iorodeo/ph_featherwing/README.md

# IO Rodeo pH Feather Wing

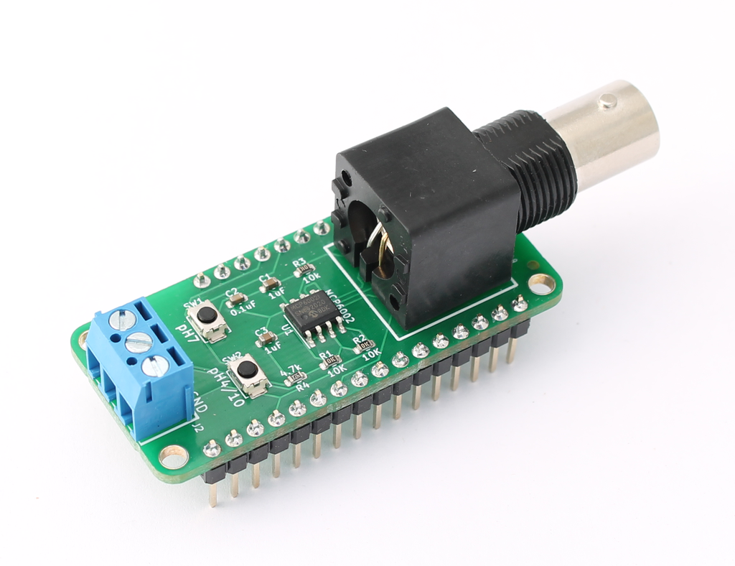
[picture p1: images/ph_feather_wing_v0p2.png]


Hardware design for IO Rodeo's pH Feather Wing (in development).
