iorodeo/ph_featherwing/v0p1/README.md

# IO Rodeo pH Feather Wing

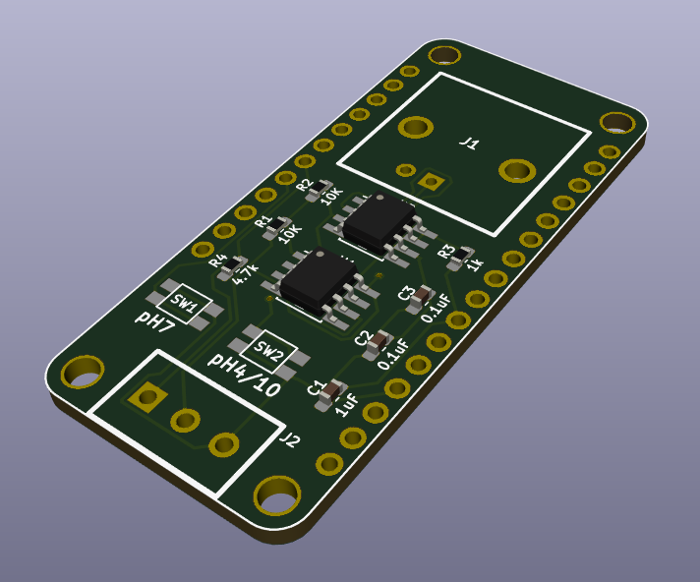
[picture p2: images/ph_feather_wing_3D_kicad.png]


Hardware design for IO Rodeo's pH Feather Wing (in development).
