iorodeo/ph_featherwing/v0p1/ph_feather_wing.pdf

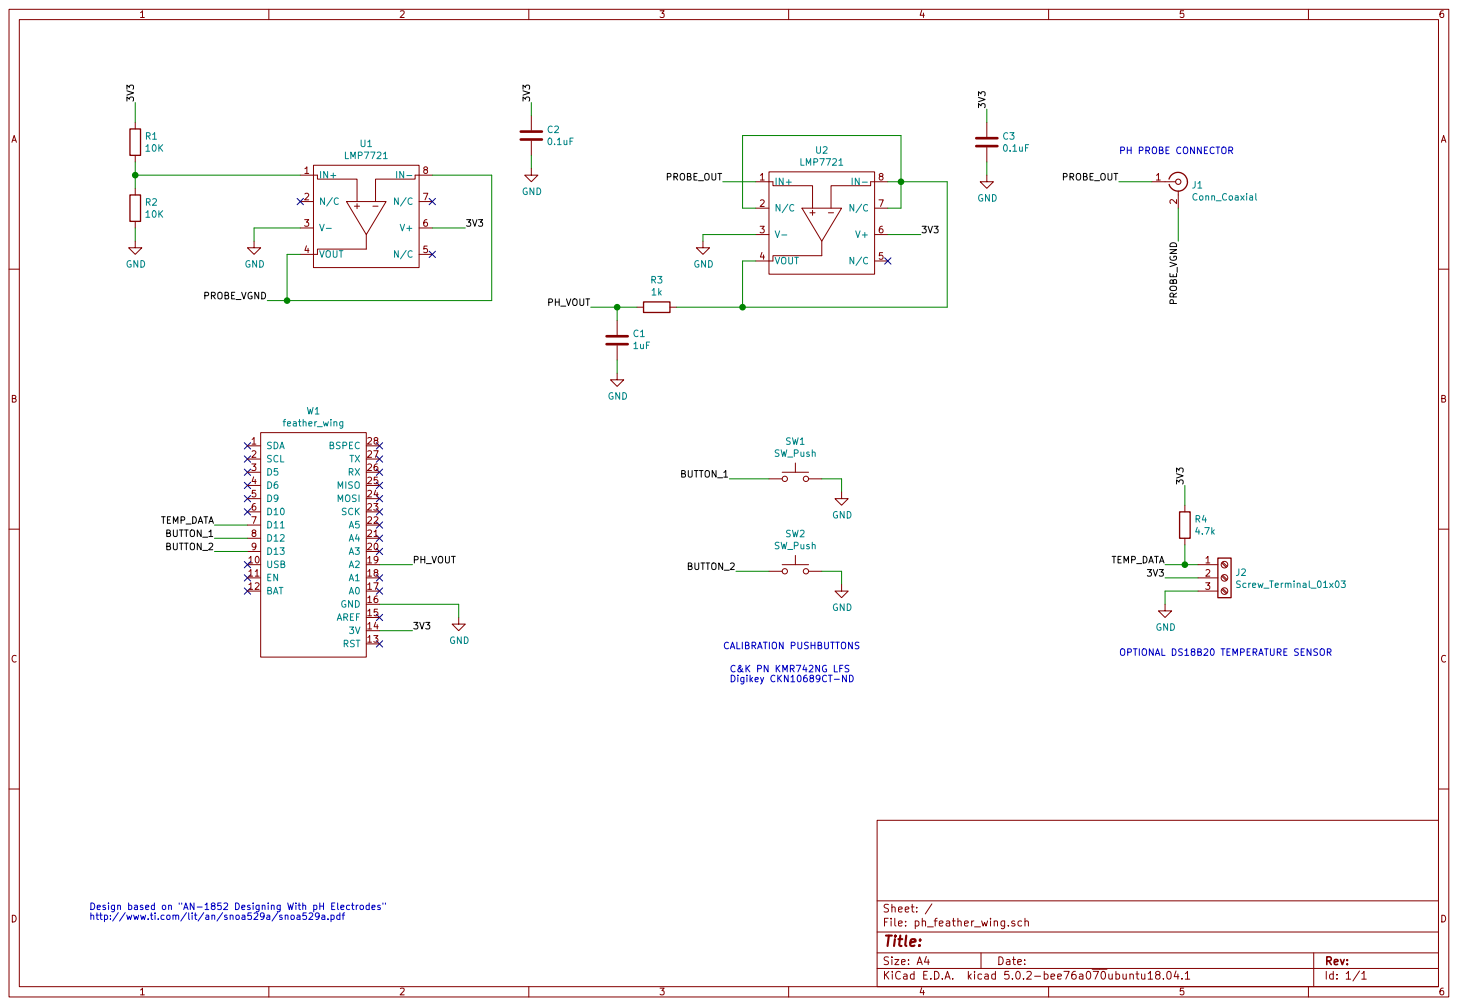
[picture p3: page 1]

J2Screw_Terminal_01x03 C2
3V3 TEMP_DATA 3V3 PH PROBE CONNECTOR OPTIONAL DS18B20 TEMPERATURE SENSOR

BUTTON_1 BUTTON_2 CALIBRATION PUSHBUTTONS C&K PN KMR742NG LFS Digikey CKN10689CT-ND

Design based on "AN-1852 Designing With pH Electrodes"
http://www.ti.com/lit/an/snoa529a/snoa529a.pdf
