iorodeo/ph_featherwing/v0p2/ph_feather_wing.pdf

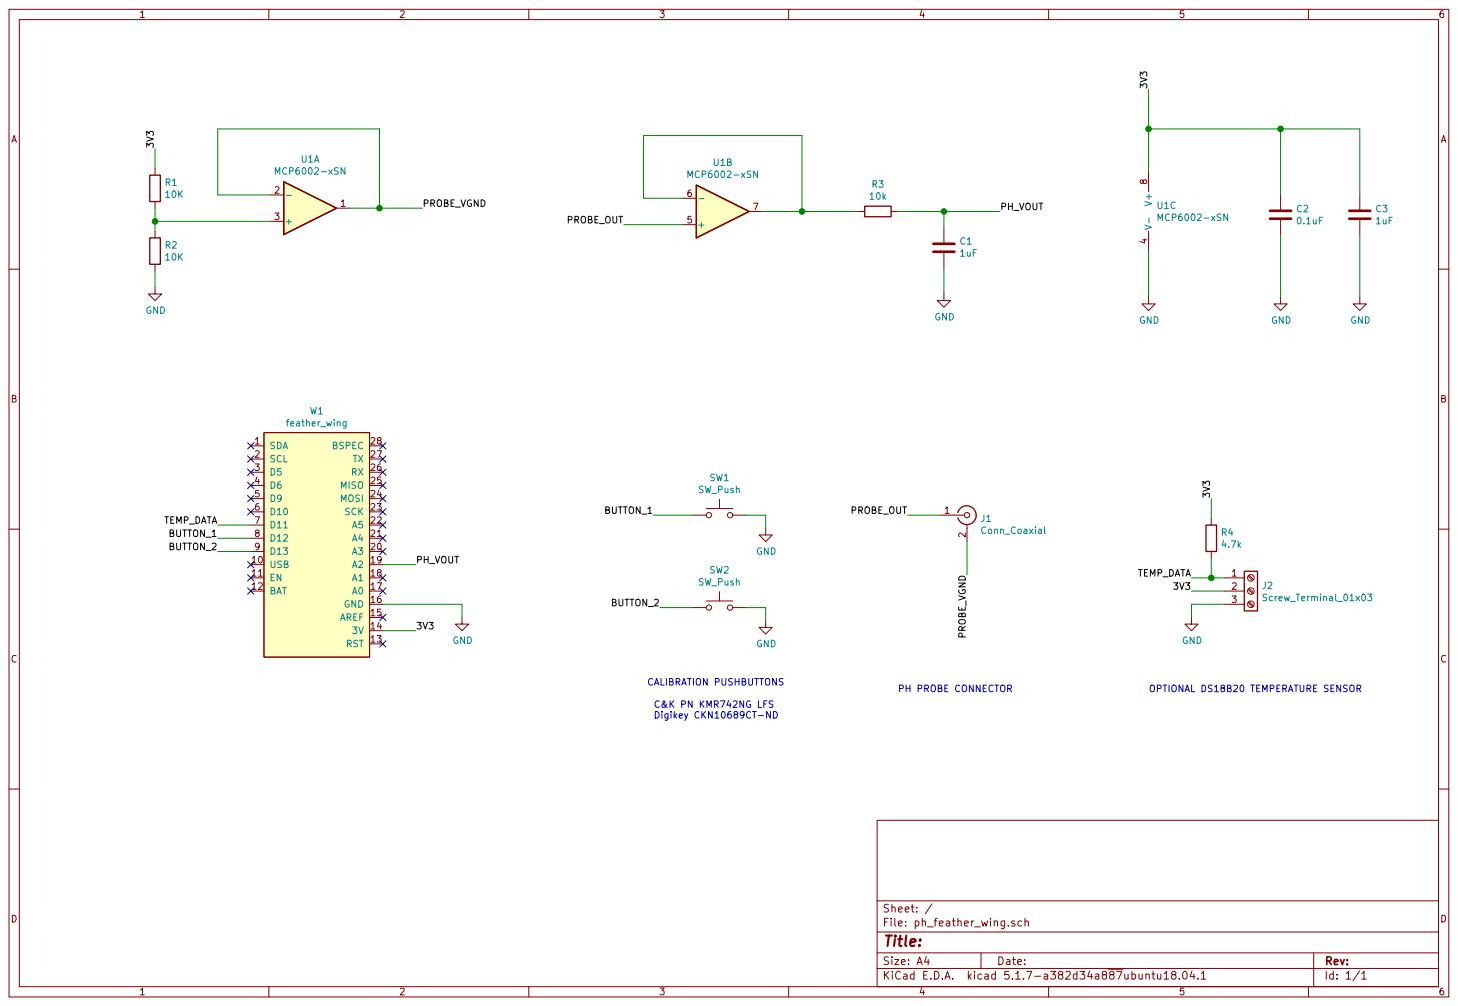
[picture p4: page 1]

C&K PN KMR742NG LFS Digikey CKN10689CT-ND
