iorodeo/ph_featherwing/(list of files, drawings)

Other design files:
v0p1/ph_feather_wing.dsn
v0p2/ph_feather_wing.dsn
