iorodeo/ph_featherwing/v0p2/ph_feather_wing.kicad_pcb

## KiCad design v0p2/ph_feather_wing.kicad_pcb (2021-01-18)

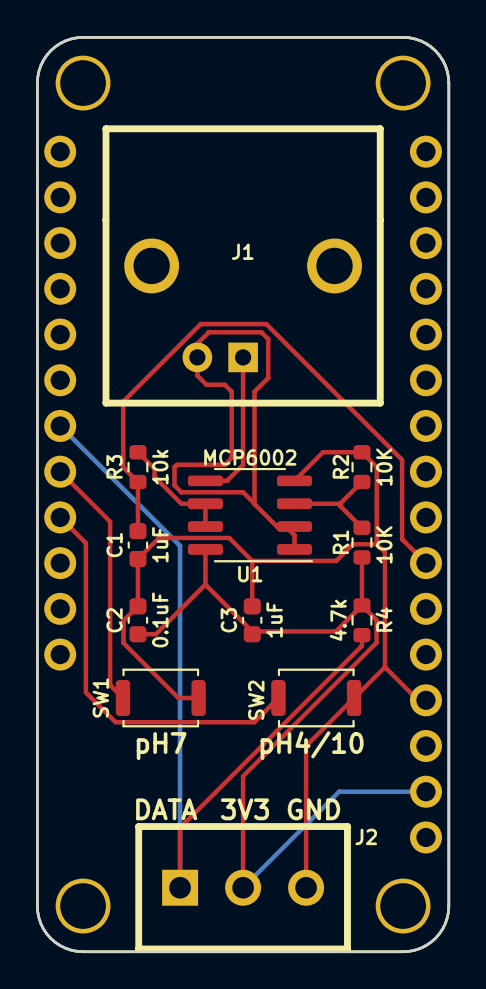
[picture p5: board v0p2/ph_feather_wing.kicad_pcb from above]

Board: 2 copper layers, 22.9 x 50.8 mm, 13 parts (0 on the bottom side), 10 nets.

Parts:
C1, C3: 1uF; C_0603_1608Metric
C2: 0.1uF; C_0603_1608Metric
J1: Conn_Coaxial; BNC
J2: Screw_Terminal_01x03; CONNBLOCK3
R1, R2: 10K; R_0603_1608Metric
R3: 10k; R_0603_1608Metric
R4: 4.7k; R_0603_1608Metric
SW1, SW2: SW_Push; SW_Push_SPST_NO_Alps_SKRK
U1: MCP6002; SOIC-8_3.9x4.9mm_P1.27mm
W1: feather_wing

Connections:
/3V3: C2.1, C3.1, J2.2, R1.1, R4.1, U1.8, W1.14
/BUTTON_1: SW1.1, W1.8
/BUTTON_2: SW2.1, W1.9
/PH_VOUT: C1.2, R3.1, W1.19
/PROBE_OUT: J1.1, U1.5
/PROBE_VGND: J1.2, U1.1, U1.2
/TEMP_DATA: J2.1, R4.2, W1.7
GND: C1.1, C2.2, C3.2, J2.3, R2.2, SW1.2, SW2.2, U1.4, W1.16
unnamed: R1.2, R2.1, U1.3
unnamed: R3.2, U1.6, U1.7
