iorodeo/ph_featherwing/v0p1/ph_feather_wing.kicad_pcb

## KiCad design v0p1/ph_feather_wing.kicad_pcb (2021-01-17)

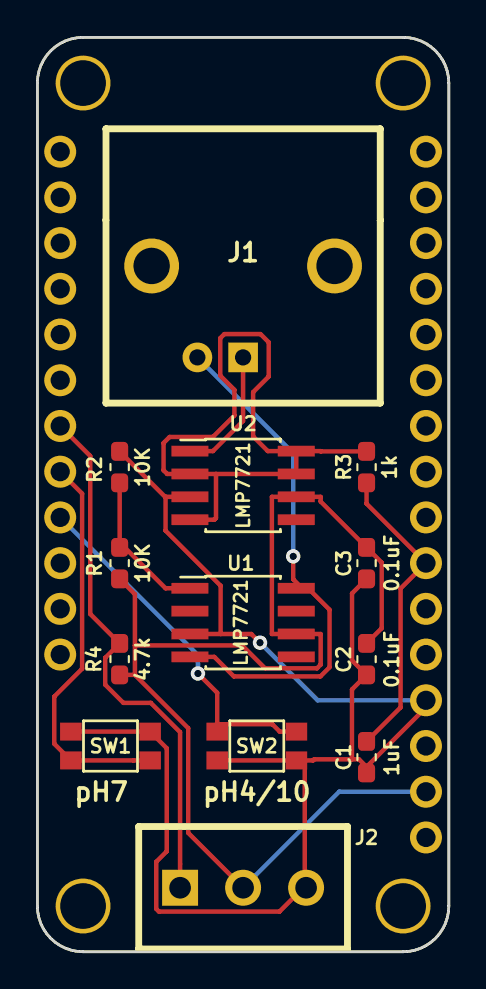
[picture p6: board v0p1/ph_feather_wing.kicad_pcb from above]

Board: 2 copper layers, 22.9 x 50.8 mm, 14 parts (0 on the bottom side), 10 nets.

Parts:
C1: 1uF; C_0603_1608Metric_Pad1.05x0.95mm_HandSolder
C2, C3: 0.1uF; C_0603_1608Metric_Pad1.05x0.95mm_HandSolder
J1: Conn_Coaxial; BNC
J2: Screw_Terminal_01x03; CONNBLOCK3
R1, R2: 10K; R_0603_1608Metric_Pad1.05x0.95mm_HandSolder
R3: 1k; R_0603_1608Metric_Pad1.05x0.95mm_HandSolder
R4: 4.7k; R_0603_1608Metric_Pad1.05x0.95mm_HandSolder
SW1, SW2: SW_Push; KMR7_SWITCH
U1, U2: LMP7721; SOIC-8_3.9x4.9mm_P1.27mm_HandSolder
W1: feather_wing

Connections:
/3V3: C2.1, C3.1, J2.2, R1.1, R4.1, U1.6, U2.6, W1.14
/BUTTON_1: SW1.1, W1.8
/BUTTON_2: SW2.1, W1.9
/PH_VOUT: C1.2, R3.2, W1.19
/PROBE_OUT: J1.1, U2.1
/PROBE_VGND: J1.2, U1.4, U1.8
/TEMP_DATA: J2.1, R4.2, W1.7
GND: C1.1, C2.2, C3.2, J2.3, R2.2, SW1.2, SW2.2, U1.3, U2.3, W1.16
unnamed: R1.2, R2.1, U1.1
unnamed: R3.1, U2.2, U2.4, U2.7, U2.8
