iorodeo/ph_featherwing/(threads)

Thread 1 (2021-04-21):

Reason for v0.2 ?

synnack, 2021-04-21:
Hi,

Cool project. Can I ask what was wrong with v0.1 other than more expensive parts (LMP7721) ? This part seems missing in the project history. It seems to match what I'm doing in a board and I'm interested in your experience with these circuits.

Thanks!

Wilco

iorodeo, 2021-04-22:
The primary reason for the design change from v0.1 to v0.2 was to reduce manufacturing costs.  It wasn't due to any issue with the v0.1 design.  The design was modified to only use components which are stocked by the PCB manufacturer/assembler.  Doing this enables us to get the boards made very quickly and at lower cost.   Moving to the lower cost op amp (from the LMP7721) helped as well, but it was more of a side a effect.

synnack, 2021-04-23:
Thank you for your reply!

Closed 2021-04-23.
