iorodeo/ph_featherwing/(commit log)

2019-02-22 Project creation.
    [ph_feather_wing-B.Cu.gbr, ph_feather_wing-B.Mask.gbr, ph_feather_wing-B.SilkS.gbr, ph_feather_wing-Edge.Cuts.gbr, ph_feather_wing-F.Cu.gbr, ph_feather_wing-F.Mask.gbr, ph_feather_wing-F.SilkS.gbr, ph_feather_wing-NPTH.drl]
2019-02-28 Added BOM.
2019-03-17 Fixed part number issue in BOM.
2019-04-01 Add pdf of schematic.
2021-01-17 Made back sild visible again.
    [ph_feather_wing.kicad_pcb]
2021-01-17 Rearranged project and began working on v0.2 of the design.
    [ph_feather_wing-B.Cu.gbr, ph_feather_wing-B.Mask.gbr, ph_feather_wing-B.SilkS.gbr, ph_feather_wing-Edge.Cuts.gbr, ph_feather_wing-F.Cu.gbr, ph_feather_wing-F.Mask.gbr, ph_feather_wing-F.SilkS.gbr, ph_feather_wing-NPTH.drl]
2021-01-18 Finished preliminary draft of version 0.2 R1.
    [ph_feather_wing-B.Cu.gbr, ph_feather_wing-B.Mask.gbr, ph_feather_wing-B.SilkS.gbr, ph_feather_wing-Edge.Cuts.gbr, ph_feather_wing-F.Cu.gbr, ph_feather_wing-F.Mask.gbr, ph_feather_wing-F.SilkS.gbr, ph_feather_wing-NPTH.drl]
2021-01-18 Added guard ring, re-routed, made r1 gerbers, added files for assembly.
    [BOM_JLCPCB.xlsx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]
2021-01-18 Added .zip of gerbers. Fixed minor issues with assembly files.
    [BOM_JLCPCB.xlsx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]
2021-01-18 Fixed component orientation in CPL file.
    [CPL_JLCPCB.xlsx]
2021-02-23 Added pdf of schematic for new version of the PCB.
